juanmb/ArduinoDomeController/DomeController/README.md

ArduinoDomeController
=====================

An astronomical observatory dome controller based on Arduino.
It uses the MaxDome II serial protocol for compatibility with existing drivers.
