juanmb/ArduinoDomeController/(commit log)

2017-06-26 Detect interference between the two shutters
    [DomeShutter.ino, shutter.cpp, shutter.h]
2017-07-01 Fix errors in the state machine. Reorder input pins
    [DomeShutter.ino, MonsterMotorShield.cpp, shutter.cpp, shutter.h]
2017-12-30 Move all files to a subfolder for merging with ArduinoDomeShutter
2018-02-16 Add button icons
2018-04-08 Add new command for reading the battery voltage
2018-04-08 Convert ADC reading to battery voltage*100
2018-04-08 Fix azimuth rotation direction when homing
    [DomeController.ino, maxdomeii.py]
2019-05-24 Fix ACK command response
    [DomeController.ino]
2019-05-30 Fix commands: status, home and goto
    [DomeController.ino]
2020-08-22 Add azimut buttons. Monster motor shield driver
